aryS55/D.R.S-Thrust-Vector-System/pcb/BOM_Board1_PCB1_2026-10-25.xlsx

No. | Quantity | Comment | Designator | Footprint | Value | Manufacturer Part | Manufacturer | Supplier Part | Supplier
1 | 1 | 2.54-1*8P母环保 | BMI323 | HDR-TH_8P-P2.54-V-F |  | 2.54-1*8P母环保 | BOOMELE(博穆精密) | C27438 | LCSC
2 | 2 | 100nF | C4,C5 | C0402 | 100nF | CC0402KRX7R7BB104 | YAGEO(国巨) | C60474 | LCSC
3 | 2 | 1uF | C6,C9 | C0603 | 1uF | CL10A105KO8NNNC | SAMSUNG(三星) | C1592 | LCSC
4 | 1 | 10uF | C8 | C0603 | 10uF | CL10A106KP8NNNC | SAMSUNG(三星) | C19702 | LCSC
5 | 1 | Diode | D1 | SOD-323_L1.8-W1.3-LS2.5-RD |  | Diode | Hottech(合科泰) | C191023 | LCSC
6 | 8 | PZ2.54-1*3 | ESC,Reciever,Servo1,Servo2,Servo3,Servo4,Servo5,Servo6 | HDR-TH_3P-P2.54-V-M |  | PZ2.54-1*3 | ZHOURI(洲日) | C5360899 | LCSC
7 | 2 | JXT-PZ2.54-1X14P-A1 | H2,H4 | HDR-TH_14P-P2.54-V-M |  | JXT-PZ2.54-1X14P-A1 | JXTCONN(聚兴泰) | C54803357 | LCSC
8 | 1 | 2.54-1*5 | H3 | HDR-TH_5P-P2.54-V-M |  | 2.54-1*5 | ZHOURI(洲日) | C5156614 | LCSC
9 | 2 | GL0603UB01 | LED4,LED5 | LED0603-RD_BLUE |  | GL0603UB01 | Guiguang light(桂光光电) | C51933294 | LCSC
10 | 1 | XL-1608SURC-06 | Parts | LED0603-RD_RED |  | XL-1608SURC-06 | XINGLIGHT(成兴光) | C965799 | LCSC
11 | 2 | 220Ω | R1,R4 | R0603 | 220Ω | FRC0603J221 TS | FOJAN(富捷) | C2907127 | LCSC
12 | 1 | 330Ω | R3 | R0402 | 330Ω | FRC0402J331 TS | FOJAN(富捷) | C2906929 | LCSC
13 | 4 | 10kΩ | R6,R7,R9,R10 | R0402 | 10kΩ | FRC0402F1002TS | FOJAN(富捷) | C2906861 | LCSC
14 | 2 | 33Ω | R11,R12 | R0603 | 33Ω | 0603WAF330JT5E | UNI-ROYAL(厚声) | C23140 | LCSC
15 | 1 | TF-CARD H1.8 | SDCard | TF-SMD_TF-CARD-H1.8 |  | TF-CARD H1.8 | SHOU HAN(首韩) | C7529389 | LCSC
16 | 1 | Teensy 4.0 | Teensy4.0 | COMM-TH_34P-L35.6-W17.8-P2.54_C9900133251 |  | Teensy 4.0 |  | C9900133251 | LCSC
17 | 1 | XC6206-3.3V | U1 | SOT-23-3_L2.9-W1.3-P0.95-LS2.4-BR |  | XC6206-3.3V | YONGYUTAI(永裕泰) | C3015484 | LCSC
