aryS55/D.R.S-Thrust-Vector-System/pcb/SCH_Schematic1_2026-10-25.pdf

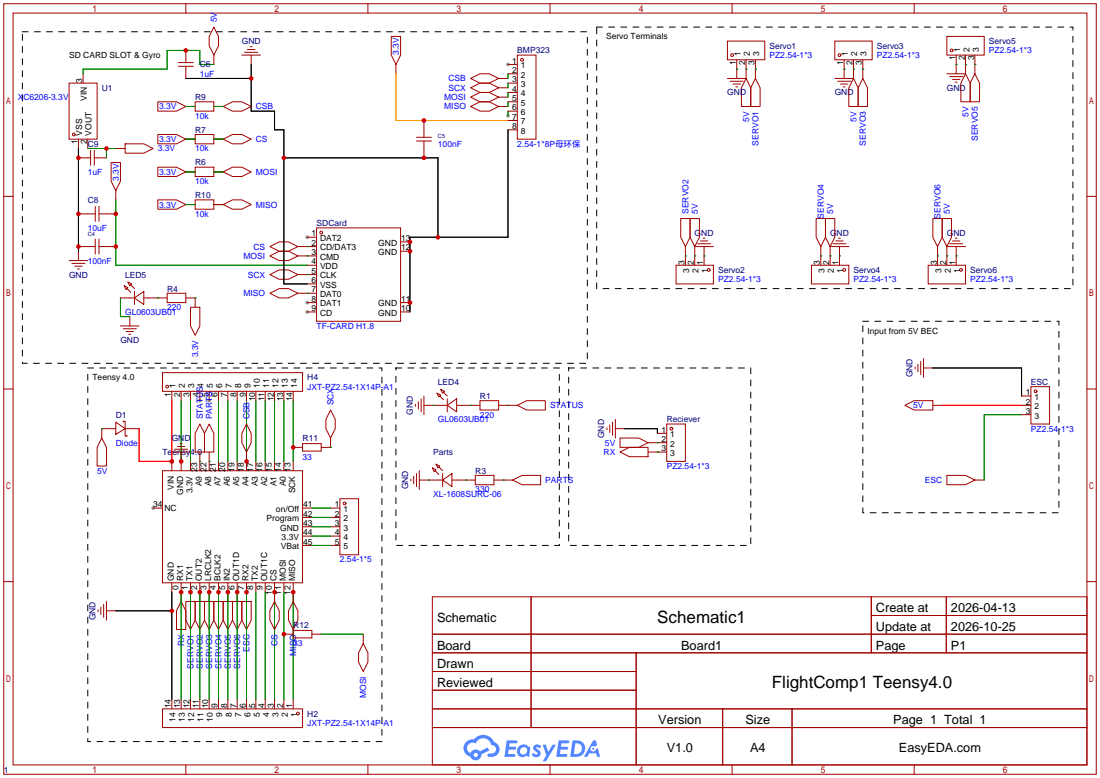
[picture p1: page 1]

SD CARD SLOT & Gyro

SCK 13 MISO 12 MOSI 11 CS 10 OUT1C

Schematic | Schematic1 | Create at | 2026-04-13

Update at | 2026-10-25

Board | Board1 | Page | P1
Drawn | | FlightComp1 Teensy4.0
Reviewed

Version | Size | Page 1 Total 1
V1.0 | A4 | EasyEDA.com
