aryS55/D.R.S-Thrust-Vector-System/(commit log)

2026-08-26 Revise README for EDF Thrust-Vectoring Hover Rocket
    Updated project description, added repository contents, hardware details, and tuning workflow.
2026-10-25 Fix link formatting for bill of materials
2026-10-26 Update Drone CAD link in README
